dillwang/Advanced-CPU-Optimization/mips_cpu/mips_core/ooo/lsq.sv

/*
 * lsq.sv
 *
 * The load/store queue. It holds every memory instruction in program order from
 * dispatch until commit and owns the single D cache port.
 *
 * Ordering rules:
 *   - Stores never touch the cache speculatively. A store computes its address
 *     and data when it issues, sits in the queue, and is written to the cache
 *     only when the reorder buffer retires it. A squashed store therefore
 *     cannot have changed memory.
 *   - A load may issue ahead of an older store whose address is not known yet.
 *     That is a guess, and this module is where it is checked: when the store
 *     finally computes its address, any younger load that already read the same
 *     word is a memory order violation, and o_mv_valid asks the reorder buffer
 *     to squash it and everything after it. Loads the predictor has marked
 *     (mem_wait) are held by the issue queue instead, using
 *     o_oldest_unresolved, and cannot violate at all.
 *   - A load that matches an older store in the queue takes its value straight
 *     from the queue instead of the cache (store to load forwarding). The
 *     youngest matching older store wins.
 *
 * The D cache reads its SRAM using addr_next a cycle ahead of addr, so an
 * access is set up in the cycle the address is computed and presented in the
 * following one.
 *
 * The cache does not block on a miss, which means an access gets one of three
 * answers in the cycle it is presented rather than simply stalling:
 *
 *   dc_out.valid    it hit; the access is finished.
 *   dc_miss_pending it missed, and miss status holding register dc_mshr_id has
 *                   taken on the fill. The access leaves the port, its queue
 *                   entry is marked waiting, and the port is free immediately.
 *                   When dc_fill_valid announces that id, every entry waiting
 *                   on it is marked for replay and put back on the port, where
 *                   it hits.
 *   neither         the cache could not take it -- no free register, or the
 *                   line is still sitting in the writeback queue. The access
 *                   stays on the port and is presented again.
 *
 * Waiting is per queue entry rather than per port, so several loads can be
 * outstanding at once and their memory latencies overlap. Loads that hit keep
 * flowing past them.
 */
`include "mips_core.svh"

module lsq (
	input clk,    // Clock
	input rst_n,  // Synchronous reset active low

	// ---- dispatch ----
	input  uop_t disp_uop [FE_WIDTH],
	output lsq_idx_t disp_lsq_idx [FE_WIDTH],
	output logic [LSQ_IDX_W : 0] lsq_free,

	// ---- issue of a memory operation ----
	// The address comes from the ALU on the issuing port, the store data from
	// the second source operand.
	input  logic mem_issue,
	input  uop_t mem_uop,
	input  logic [`ADDR_WIDTH - 1 : 0] mem_addr,
	input  logic [`DATA_WIDTH - 1 : 0] mem_data,

	// ---- constraints published back to the issue queue ----
	output logic o_accept,
	output logic o_load_free,
	output logic o_has_unresolved,
	output rob_idx_t o_oldest_unresolved,
	input  rob_idx_t rob_head,

	// ---- memory order violation ----
	// A store has just found that this load read the word it is about to
	// write. Raised one cycle after the store computes its address, so that
	// the squash it causes does not feed back into the issue it came from.
	output logic o_mv_valid,
	output rob_idx_t o_mv_rob_idx,

	// ---- load writeback ----
	output logic ld_wb_valid,
	output rob_idx_t ld_wb_rob_idx,
	output preg_t ld_wb_pd,
	output logic ld_wb_writes,
	output logic [`DATA_WIDTH - 1 : 0] ld_wb_data,
	output logic [`ADDR_WIDTH - 1 : 0] ld_wb_addr,

	// ---- the committing store ----
	input  logic st_valid,
	input  logic [`ADDR_WIDTH - 1 : 0] st_addr,
	input  logic [`DATA_WIDTH - 1 : 0] st_data,
	output logic st_done,

	// ---- deallocation, driven by commit ----
	input  logic commit_en [FE_WIDTH],
	input  rob_idx_t commit_rob_idx [FE_WIDTH],
	input  logic commit_is_mem [FE_WIDTH],

	// ---- squash ----
	input  logic squash,
	input  rob_idx_t squash_head,
	input  logic [ROB_IDX_W : 0] squash_count,

	// ---- D cache ----
	d_cache_input_ifc.out dc_in,
	cache_output_ifc.in dc_out,
	// The access presented this cycle missed, and is covered by dc_mshr_id.
	input  logic dc_miss_pending,
	input  mshr_id_t dc_mshr_id,
	// That register's line has landed; anything waiting on it may be replayed.
	input  logic dc_fill_valid,
	input  mshr_id_t dc_fill_id
);

`ifdef SIMULATION
	import "DPI-C" function void stats_event (input string e);
`endif

	typedef struct packed {
		logic valid;
		logic is_store;
		rob_idx_t rob_idx;
		logic addr_valid;
		logic [`ADDR_WIDTH - 1 : 0] addr;
		logic [`DATA_WIDTH - 1 : 0] data;
		// A load that missed sits here, off the D cache port, until the fill it
		// is waiting on lands; it is then marked for replay and put back on.
		logic waiting;
		logic replay;
		mshr_id_t mshr_id;
		// Where a replayed load writes back. The issuing uop is long gone by
		// then, so the queue has to carry the destination itself.
		preg_t pd;
		logic writes;
		// For a load, the store it took its value from, if any. A store that
		// resolves late is only a violation for loads that did not already
		// forward from a store younger than it.
		logic fwd_valid;
		rob_idx_t fwd_src;
	} lsq_entry_t;

	lsq_entry_t e [LSQ_ENTRIES];
	lsq_idx_t lsq_head, lsq_tail;
	logic [LSQ_IDX_W : 0] lsq_count;

	// The access presented to the D cache this cycle. This is a one deep
	// pipeline register rather than a state machine: the cache addresses its
	// SRAM from addr_next and compares tags against addr, which are a cycle
	// apart, so an access can be set up in the same cycle that the previous one
	// completes. An idle-per-access state machine cannot do that and caps the
	// port at one access every two cycles, which on a load heavy program is the
	// binding limit long before the cache itself is.
	logic acc_valid;
	logic acc_is_store;
	logic [`ADDR_WIDTH - 1 : 0] acc_addr;
	logic [`DATA_WIDTH - 1 : 0] acc_data;	// store data
	rob_idx_t acc_rob;						// load identity
	preg_t acc_pd;
	logic acc_writes;
	logic acc_killed;
	lsq_idx_t acc_lsq;		// the entry to mark waiting if this access misses
	// Set for one cycle when a forwarded load will write back next cycle. The
	// access on the port is not presented to the cache that cycle, so it cannot
	// answer at the same time and contend for the single load writeback port.
	logic acc_hold;

	// The access to present next cycle, and whose address goes out on
	// addr_next now.
	logic nxt_valid;
	logic nxt_is_store;
	logic [`ADDR_WIDTH - 1 : 0] nxt_addr;
	logic [`DATA_WIDTH - 1 : 0] nxt_data;
	rob_idx_t nxt_rob;
	preg_t nxt_pd;
	logic nxt_writes;
	logic nxt_killed;
	lsq_idx_t nxt_lsq;
	logic nxt_hold;

	// A committing store that missed. It stays in the reorder buffer with
	// st_valid asserted, and is put back on the port when its fill lands.
	logic st_wait_valid;
	mshr_id_t st_wait_mshr;

	// ||||||||||||||||||||||||||||||||||||||||||||||||||||||||||||||||||||||||
	// |||| Disambiguation
	// ||||||||||||||||||||||||||||||||||||||||||||||||||||||||||||||||||||||||
	// The oldest store that has not yet produced an address. The issue queue
	// uses this to hold back any load younger than it.
	always_comb
	begin
		o_has_unresolved = 1'b0;
		o_oldest_unresolved = '0;
		for (int i = 0; i < LSQ_ENTRIES; i++)
		begin
			automatic logic [ROB_IDX_W : 0] a =
				{1'b0, rob_idx_t'(e[i].rob_idx - rob_head)};
			if (e[i].valid && e[i].is_store && !e[i].addr_valid)
			begin
				if (!o_has_unresolved
					|| (a < {1'b0, rob_idx_t'(o_oldest_unresolved - rob_head)}))
				begin
					o_has_unresolved = 1'b1;
					o_oldest_unresolved = e[i].rob_idx;
				end
			end
		end
	end

	// Store to load forwarding: the youngest store that is older than the
	// issuing load and hits the same word supplies the data.
	logic fwd_hit;
	logic [`DATA_WIDTH - 1 : 0] fwd_data;
	rob_idx_t fwd_src;
	logic [ROB_IDX_W : 0] issue_age;

	always_comb
	begin
		automatic logic [ROB_IDX_W : 0] best_age = '0;

		issue_age = {1'b0, rob_idx_t'(mem_uop.rob_idx - rob_head)};
		fwd_hit = 1'b0;
		fwd_data = '0;
		fwd_src = '0;

		for (int i = 0; i < LSQ_ENTRIES; i++)
		begin
			automatic logic [ROB_IDX_W : 0] a =
				{1'b0, rob_idx_t'(e[i].rob_idx - rob_head)};
			if (e[i].valid && e[i].is_store && e[i].addr_valid
				&& (a < issue_age) && (e[i].addr == mem_addr))
			begin
				// Keep the youngest match, which is the store that would have
				// been the last to write this word before the load runs.
				if (!fwd_hit || (a > best_age))
				begin
					fwd_hit = 1'b1;
					fwd_data = e[i].data;
					fwd_src = e[i].rob_idx;
					best_age = a;
				end
			end
		end
	end

	// ||||||||||||||||||||||||||||||||||||||||||||||||||||||||||||||||||||||||
	// |||| Memory order violation
	// ||||||||||||||||||||||||||||||||||||||||||||||||||||||||||||||||||||||||
	// A store computing its address late can find that a younger load has
	// already run and read the word it is about to write. That load took its
	// value from the cache, or forwarded from a store older than this one, and
	// is wrong -- as is everything that used it.
	//
	// This is the only cycle it can be discovered in. A load that has already
	// issued has already chosen where its data comes from, at issue, so the
	// check has to happen against every younger load that has an address.
	//
	// The oldest offender wins: squashing it takes the younger ones with it.
	logic mv_hit;
	rob_idx_t mv_rob;

	always_comb
	begin
		automatic logic [ROB_IDX_W : 0] best = '0;
		automatic logic [ROB_IDX_W : 0] s_age =
			{1'b0, rob_idx_t'(mem_uop.rob_idx - rob_head)};
		automatic logic st_issue = mem_issue && (mem_uop.mem_action == WRITE);

		mv_hit = 1'b0;
		mv_rob = '0;

		for (int i = 0; i < LSQ_ENTRIES; i++)
		begin
			automatic logic [ROB_IDX_W : 0] a =
				{1'b0, rob_idx_t'(e[i].rob_idx - rob_head)};
			// A load that forwarded from a store younger than this one already
			// holds the right value: this store is not the last write to that
			// word before it.
			automatic logic covered = e[i].fwd_valid
				&& ({1'b0, rob_idx_t'(e[i].fwd_src - rob_head)} > s_age);

			// MDP_STRESS drops the address test, so every store that resolves
			// behind an issued load reports a violation. Real programs almost
			// never alias here, which would leave the recovery path untested;
			// under stress it fires constantly and the golden traces still have
			// to match. Correctness only -- it is ruinously slow.
`ifdef MDP_STRESS
			if (st_issue && e[i].valid && !e[i].is_store && e[i].addr_valid
				&& (a > s_age))
`else
			if (st_issue && e[i].valid && !e[i].is_store && e[i].addr_valid
				&& (a > s_age) && (e[i].addr == mem_addr) && !covered)
`endif
			begin
				if (!mv_hit || (a < best))
				begin
					mv_hit = 1'b1;
					mv_rob = e[i].rob_idx;
					best = a;
				end
			end
		end
	end

	// Registered, and this is not optional: the squash it raises reaches the
	// issue queue, which is what produced the store issue that detected it.
	// Passing it out combinationally would close that loop. One cycle later
	// nothing has changed that matters -- the load cannot commit, because the
	// store that caught it is older and has not committed either.
	logic mv_pend_valid;
	rob_idx_t mv_pend_rob;
	logic mv_keep_pending;

	// If a second violation is found while one is still pending, the older of
	// the two is kept, because its squash covers the younger one anyway.
	assign mv_keep_pending = mv_pend_valid
		&& ({1'b0, rob_idx_t'(mv_rob - rob_head)}
			>= {1'b0, rob_idx_t'(mv_pend_rob - rob_head)});

	assign o_mv_valid = mv_pend_valid;
	assign o_mv_rob_idx = mv_pend_rob;

	// ||||||||||||||||||||||||||||||||||||||||||||||||||||||||||||||||||||||||
	// |||| D cache port
	// ||||||||||||||||||||||||||||||||||||||||||||||||||||||||||||||||||||||||
	// Priority on the port: an unfinished access keeps it, then a committing
	// store, then the oldest load whose fill has landed, then a newly issuing
	// load. Replays come before new loads so that a load which has already paid
	// for a miss cannot be starved by a stream of hits behind it.
	logic start_load;
	logic start_store;
	logic start_replay;
	logic store_slot;
	logic load_slot;
	logic acc_abandon;		// a squashed load, whose answer nobody wants
	logic acc_done;
	logic dc_present;		// the access is actually in front of the cache
	logic port_free;

	// The oldest entry whose fill has arrived.
	logic replay_found;
	lsq_idx_t replay_idx;

	always_comb
	begin
		automatic logic [ROB_IDX_W : 0] best = '0;

		replay_found = 1'b0;
		replay_idx = '0;
		for (int i = 0; i < LSQ_ENTRIES; i++)
		begin
			automatic logic [ROB_IDX_W : 0] a =
				{1'b0, rob_idx_t'(e[i].rob_idx - rob_head)};
			if (e[i].valid && e[i].replay)
			begin
				if (!replay_found || (a < best))
				begin
					replay_found = 1'b1;
					replay_idx = lsq_idx_t'(i);
					best = a;
				end
			end
		end
	end

	assign acc_abandon = acc_valid && !acc_is_store && acc_killed;
	assign dc_present = acc_valid && !acc_abandon && !acc_hold;
	// A hit and a miss both take the access off the port; only a refusal keeps
	// it. A miss is not a stall any more, so the port frees up in the cycle the
	// miss is taken and the very next access can go out behind it.
	assign acc_done = acc_valid && (acc_abandon
		|| (dc_present && (dc_out.valid || dc_miss_pending)));
	// The port can take a new access whenever it is empty or the access on it
	// finishes this cycle. That last case is what makes it a pipeline: the
	// finishing access is still being compared against addr while the next one
	// is already addressing the SRAM through addr_next.
	assign port_free = !acc_valid || acc_done;

	// A store that is already on the port, or that missed and is waiting for
	// its line, must not be launched a second time; st_valid stays asserted
	// until st_done answers it.
	assign store_slot = st_valid && !st_wait_valid
		&& !(acc_valid && acc_is_store);
	assign start_store = store_slot && port_free;
	assign start_replay = port_free && !start_store && replay_found;
	assign load_slot = port_free && !store_slot && !replay_found;
	assign start_load = mem_issue && (mem_uop.mem_action == READ) && !fwd_hit
		&& load_slot;

	// A forwarded load does not need the port at all, so a memory operation may
	// issue whenever the writeback port is not about to be contended. The one
	// cycle acc_hold takes the port out of the cache's view is also the one
	// cycle nothing new is allowed to issue, which bounds the hold to a cycle.
	assign o_accept = !acc_hold;
	// A load can only be set up when nothing else is claiming the port, since
	// the cache SRAM has to be addressed a cycle in advance. This must be the
	// exact predicate start_load uses, or a load the issue queue has already
	// dropped would never reach the port.
	assign o_load_free = load_slot;

	// A load that will be answered from the store queue next cycle. The cache
	// path has to stay quiet then, since they share one writeback port.
	logic fwd_next;
	assign fwd_next = mem_issue && (mem_uop.mem_action == READ) && fwd_hit;

	always_comb
	begin
		nxt_valid = 1'b0;
		nxt_is_store = 1'b0;
		nxt_addr = '0;
		nxt_data = '0;
		nxt_rob = '0;
		nxt_pd = '0;
		nxt_writes = 1'b0;
		nxt_killed = 1'b0;
		nxt_lsq = '0;

		if (acc_valid && !acc_done)
		begin
			// Refused, or held back for the writeback port: hold everything,
			// including addr_next, so the SRAM read is set up again.
			nxt_valid = 1'b1;
			nxt_is_store = acc_is_store;
			nxt_addr = acc_addr;
			nxt_data = acc_data;
			nxt_rob = acc_rob;
			nxt_pd = acc_pd;
			nxt_writes = acc_writes;
			nxt_lsq = acc_lsq;
			nxt_killed = acc_killed
				|| (squash && !acc_is_store
					&& ({1'b0, rob_idx_t'(acc_rob - squash_head)} >= squash_count));
		end
		else if (start_store)
		begin
			nxt_valid = 1'b1;
			nxt_is_store = 1'b1;
			nxt_addr = st_addr;
			nxt_data = st_data;
		end
		else if (start_replay)
		begin
			nxt_valid = 1'b1;
			nxt_addr = e[replay_idx].addr;
			nxt_rob = e[replay_idx].rob_idx;
			nxt_pd = e[replay_idx].pd;
			nxt_writes = e[replay_idx].writes;
			nxt_lsq = replay_idx;
			nxt_killed = squash
				&& ({1'b0, rob_idx_t'(e[replay_idx].rob_idx - squash_head)}
					>= squash_count);
		end
		else if (start_load)
		begin
			nxt_valid = 1'b1;
			nxt_addr = mem_addr;
			nxt_rob = mem_uop.rob_idx;
			nxt_pd = mem_uop.pd;
			nxt_writes = mem_uop.uses_rw;
			nxt_lsq = mem_uop.lsq_idx;
		end

		nxt_hold = nxt_valid && !nxt_is_store && fwd_next;
	end

	always_comb
	begin
		dc_in.valid = dc_present;
		dc_in.mem_action = acc_is_store ? WRITE : READ;
		dc_in.addr = acc_addr;
		dc_in.data = acc_data;
		// The address the cache should read its SRAM at for next cycle. When
		// nothing follows, leave the current address there rather than zero, so
		// a stalled access keeps its own row selected.
		dc_in.addr_next = nxt_valid ? nxt_addr : acc_addr;
	end

	assign st_done = acc_valid && acc_is_store && dc_present && dc_out.valid;

	// The register the cache names may be retiring on this very cycle, in which
	// case its fill announcement has already gone past and waiting on it would
	// never end. Go straight to replay instead.
	logic fill_now;
	assign fill_now = dc_fill_valid && (dc_fill_id == dc_mshr_id);

	// ||||||||||||||||||||||||||||||||||||||||||||||||||||||||||||||||||||||||
	// |||| Load writeback
	// ||||||||||||||||||||||||||||||||||||||||||||||||||||||||||||||||||||||||
	// A forwarded load is answered the cycle after it issues; a load that went
	// to the cache is answered when the cache returns.
	logic fwd_pending;
	rob_idx_t fwd_rob;
	preg_t fwd_pd;
	logic fwd_writes;
	logic [`DATA_WIDTH - 1 : 0] fwd_val;
	logic [`ADDR_WIDTH - 1 : 0] fwd_addr;

	// A squash landing on the same cycle as a completion cancels that
	// completion only when the load is genuinely on the wrong path. Cancelling
	// unconditionally would drop the result of a load that survived, and its
	// reorder buffer entry would then never complete.
	logic fwd_squashed, ld_squashed;
	assign fwd_squashed = squash
		&& ({1'b0, rob_idx_t'(fwd_rob - squash_head)} >= squash_count);
	assign ld_squashed = squash
		&& ({1'b0, rob_idx_t'(acc_rob - squash_head)} >= squash_count);

	always_comb
	begin
		if (fwd_pending)
		begin
			ld_wb_valid = ~fwd_squashed;
			ld_wb_rob_idx = fwd_rob;
			ld_wb_pd = fwd_pd;
			ld_wb_writes = fwd_writes;
			ld_wb_data = fwd_val;
			ld_wb_addr = fwd_addr;
		end
		else
		begin
			ld_wb_valid = acc_valid && !acc_is_store && dc_present
				&& dc_out.valid && !acc_killed && !ld_squashed;
			ld_wb_rob_idx = acc_rob;
			ld_wb_pd = acc_pd;
			ld_wb_writes = acc_writes;
			ld_wb_data = dc_out.data;
			ld_wb_addr = acc_addr;
		end
	end

	// ||||||||||||||||||||||||||||||||||||||||||||||||||||||||||||||||||||||||
	// |||| Allocation
	// ||||||||||||||||||||||||||||||||||||||||||||||||||||||||||||||||||||||||
	logic [LSQ_IDX_W : 0] alloc_n;

	always_comb
	begin
		alloc_n = '0;
		for (int k = 0; k < FE_WIDTH; k++)
		begin
			disp_lsq_idx[k] = lsq_idx_t'(lsq_tail + alloc_n[LSQ_IDX_W - 1 : 0]);
			if (disp_uop[k].valid && disp_uop[k].is_mem)
				alloc_n = alloc_n + 1'b1;
		end
		lsq_free = (LSQ_ENTRIES - 1) - lsq_count;
	end

	// ||||||||||||||||||||||||||||||||||||||||||||||||||||||||||||||||||||||||
	// |||| State update
	// ||||||||||||||||||||||||||||||||||||||||||||||||||||||||||||||||||||||||
	logic [LSQ_IDX_W : 0] dealloc_n;
	logic [LSQ_IDX_W : 0] survivors;

	always_ff @(posedge clk)
	begin
		if (~rst_n)
		begin
			for (int i = 0; i < LSQ_ENTRIES; i++)
			begin
				e[i].valid <= 1'b0;
				e[i].addr_valid <= 1'b0;
				e[i].waiting <= 1'b0;
				e[i].replay <= 1'b0;
			end
			lsq_head <= '0;
			lsq_tail <= '0;
			lsq_count <= '0;
			acc_valid <= 1'b0;
			acc_is_store <= 1'b0;
			acc_killed <= 1'b0;
			acc_hold <= 1'b0;
			st_wait_valid <= 1'b0;
			fwd_pending <= 1'b0;
			mv_pend_valid <= 1'b0;
		end
		else
		begin
			// The D cache port, advanced by one access.
			acc_valid <= nxt_valid;
			acc_is_store <= nxt_is_store;
			acc_addr <= nxt_addr;
			acc_data <= nxt_data;
			acc_rob <= nxt_rob;
			acc_pd <= nxt_pd;
			acc_writes <= nxt_writes;
			acc_killed <= nxt_killed;
			acc_lsq <= nxt_lsq;
			acc_hold <= nxt_hold;
			// Driven from exactly one place, so that the squash handling below
			// cannot silently override a forward being set this cycle.
			fwd_pending <= mem_issue && (mem_uop.mem_action == READ) && fwd_hit;

			// ---- issue: record the address, and the data for a store ----
			if (mem_issue)
			begin
				e[mem_uop.lsq_idx].addr <= mem_addr;
				e[mem_uop.lsq_idx].addr_valid <= 1'b1;
				if (mem_uop.mem_action == WRITE)
					e[mem_uop.lsq_idx].data <= mem_data;
				else
				begin
					// Kept so a replay after a miss can write back without the
					// uop, which is retired from the issue queue by then.
					e[mem_uop.lsq_idx].pd <= mem_uop.pd;
					e[mem_uop.lsq_idx].writes <= mem_uop.uses_rw;
					// And which store it took its value from, so a store that
					// resolves later can tell whether it was overtaken.
					e[mem_uop.lsq_idx].fwd_valid <= fwd_hit;
					e[mem_uop.lsq_idx].fwd_src <= fwd_src;
				`ifdef SIMULATION
					if (o_has_unresolved
						&& (issue_age > {1'b0,
							rob_idx_t'(o_oldest_unresolved - rob_head)}))
						stats_event("memdep_speculated");
				`endif
				end

				// A load that misses the forwarding path is picked up by the
				// port logic above, which owns acc_* outright so that a squash
				// arriving on the same edge cannot race it.
				if ((mem_uop.mem_action == READ) && fwd_hit)
				begin
					fwd_rob <= mem_uop.rob_idx;
					fwd_pd <= mem_uop.pd;
					fwd_writes <= mem_uop.uses_rw;
					fwd_val <= fwd_data;
					fwd_addr <= mem_addr;
				`ifdef SIMULATION
					stats_event("store_forward");
				`endif
				end
			end

			// ---- memory order violation, held for one cycle ----
			if (mv_hit && !mv_keep_pending)
			begin
				mv_pend_valid <= 1'b1;
				mv_pend_rob <= mv_rob;
			end
			else
				mv_pend_valid <= 1'b0;

			// ---- a fill lands: everything behind it may be replayed ----
			if (dc_fill_valid)
			begin
				for (int i = 0; i < LSQ_ENTRIES; i++)
				begin
					if (e[i].valid && e[i].waiting && (e[i].mshr_id == dc_fill_id))
					begin
						e[i].waiting <= 1'b0;
						e[i].replay <= 1'b1;
					end
				end

				if (st_wait_valid && (dc_fill_id == st_wait_mshr))
					st_wait_valid <= 1'b0;
			end

			// ---- a replay claims the port ----
			if (start_replay)
				e[replay_idx].replay <= 1'b0;

			// ---- the access on the port missed ----
			// It leaves the port either way; a load parks in its queue entry
			// and a committing store parks in st_wait, and both come back when
			// the fill is announced.
			if (dc_present && dc_miss_pending)
			begin
				if (acc_is_store)
				begin
					st_wait_valid <= !fill_now;
					st_wait_mshr <= dc_mshr_id;
				end
				else
				begin
					e[acc_lsq].waiting <= !fill_now;
					e[acc_lsq].replay <= fill_now;
					e[acc_lsq].mshr_id <= dc_mshr_id;
				end
			`ifdef SIMULATION
				stats_event("lsq_miss_park");
			`endif
			end

			// ---- allocation ----
			for (int k = 0; k < FE_WIDTH; k++)
			begin
				if (disp_uop[k].valid && disp_uop[k].is_mem)
				begin
					e[disp_lsq_idx[k]].valid <= 1'b1;
					e[disp_lsq_idx[k]].is_store <= (disp_uop[k].mem_action == WRITE);
					e[disp_lsq_idx[k]].rob_idx <= disp_uop[k].rob_idx;
					e[disp_lsq_idx[k]].addr_valid <= 1'b0;
					e[disp_lsq_idx[k]].waiting <= 1'b0;
					e[disp_lsq_idx[k]].replay <= 1'b0;
				end
			end

			// ---- deallocation on commit ----
			dealloc_n = '0;
			for (int k = 0; k < FE_WIDTH; k++)
			begin
				if (commit_en[k] && commit_is_mem[k])
				begin
					e[lsq_idx_t'(lsq_head + dealloc_n[LSQ_IDX_W - 1 : 0])].valid <= 1'b0;
					e[lsq_idx_t'(lsq_head + dealloc_n[LSQ_IDX_W - 1 : 0])].addr_valid <= 1'b0;
					e[lsq_idx_t'(lsq_head + dealloc_n[LSQ_IDX_W - 1 : 0])].waiting <= 1'b0;
					e[lsq_idx_t'(lsq_head + dealloc_n[LSQ_IDX_W - 1 : 0])].replay <= 1'b0;
					dealloc_n = dealloc_n + 1'b1;
				end
			end

			lsq_head <= lsq_idx_t'(lsq_head + dealloc_n[LSQ_IDX_W - 1 : 0]);
			lsq_tail <= lsq_idx_t'(lsq_tail + alloc_n[LSQ_IDX_W - 1 : 0]);
			lsq_count <= lsq_count - dealloc_n + alloc_n;

			// ---- squash ----
			if (squash)
			begin
				survivors = '0;
				for (int i = 0; i < LSQ_ENTRIES; i++)
				begin
					if (e[i].valid)
					begin
						if ({1'b0, rob_idx_t'(e[i].rob_idx - squash_head)} >= squash_count)
						begin
							e[i].valid <= 1'b0;
							e[i].addr_valid <= 1'b0;
							// A wrong path load waiting on a fill simply stops
							// waiting. The fill still lands in the cache.
							e[i].waiting <= 1'b0;
							e[i].replay <= 1'b0;
						end
						else
							survivors = survivors + 1'b1;
					end
				end

				// A load already talking to the cache may now be wrong path.
				// That is handled where acc_* is computed, which carries the
				// kill into nxt_killed rather than writing acc_killed from two
				// places on the same edge.

				lsq_count <= survivors - dealloc_n;
				lsq_tail <= lsq_idx_t'(lsq_head + dealloc_n[LSQ_IDX_W - 1 : 0]
					+ (survivors[LSQ_IDX_W - 1 : 0] - dealloc_n[LSQ_IDX_W - 1 : 0]));
			end
		end
	end

`ifdef SIMULATION
	// Cycles with at least one load parked on a fill. Compare against the
	// cycle count to see how much of the run is covered by an outstanding miss,
	// and against Dmiss_inflight to see how much of that overlaps.
	always_ff @(posedge clk)
	begin
		if (rst_n)
		begin
			for (int i = 0; i < LSQ_ENTRIES; i++)
			begin
				if (e[i].valid && e[i].waiting)
				begin
					stats_event("lsq_wait_cycle");
					break;
				end
			end
		end
	end
`endif

endmodule
