dillwang/Advanced-CPU-Optimization/mips_cpu/mips_core/alu.sv

/*
 * alu.sv
 * Author: Pravin P. Prabhu & Zinsser Zhang
 * Last Revision: 04/08/2018
 *
 * Defines the input and output interface of arithmetic logic unit in execution
 * stage. Implement the alu which can do arithmetic calculations and branch
 * resolution.
 *
 * It is also reponsible for reporting customized MTC0 instructions
 * to pass_done interface. See wiki page "Pass Done Interface" for details.
 */
`include "mips_core.svh"

interface alu_input_ifc ();
	logic valid;
	mips_core_pkg::AluCtl alu_ctl;
	logic signed [`DATA_WIDTH - 1 : 0] op1;
	logic signed [`DATA_WIDTH - 1 : 0] op2;

	modport in  (input valid, alu_ctl, op1, op2);
	modport out (output valid, alu_ctl, op1, op2);
endinterface

interface alu_output_ifc ();
	logic valid;
	logic [`DATA_WIDTH - 1 : 0] result;
	mips_core_pkg::BranchOutcome branch_outcome;

	modport in  (input valid, result, branch_outcome);
	modport out (output valid, result, branch_outcome);
endinterface

module alu (
	alu_input_ifc.in in,
	alu_output_ifc.out out,
	output logic done
);

	always_comb
	begin
		out.valid = 1'b0;
		out.result = '0;
		out.branch_outcome = NOT_TAKEN;
		done = 1'b0;

		if (in.valid)
		begin
			out.valid = 1'b1;

			case (in.alu_ctl)
				ALUCTL_NOP:  out.result = '0;
				ALUCTL_ADD:  out.result = in.op1 + in.op2;
				ALUCTL_ADDU: out.result = in.op1 + in.op2;
				ALUCTL_SUB:  out.result = in.op1 - in.op2;
				ALUCTL_SUBU: out.result = in.op1 - in.op2;
				ALUCTL_AND:  out.result = in.op1 & in.op2;
				ALUCTL_OR:   out.result = in.op1 | in.op2;
				ALUCTL_XOR:  out.result = in.op1 ^ in.op2;
				ALUCTL_SLT:  out.result = in.op1 < in.op2;
				ALUCTL_SLTU: out.result = unsigned'(in.op1) < unsigned'(in.op2);
				ALUCTL_SLL:  out.result = in.op1 << unsigned'(in.op2);
				ALUCTL_SRL:  out.result = in.op1 >> unsigned'(in.op2);
				ALUCTL_SRA:  out.result = in.op1 >>> unsigned'(in.op2);
				ALUCTL_SLLV: out.result = in.op2 << in.op1[4:0];
				ALUCTL_SRLV: out.result = in.op2 >> in.op1[4:0];
				ALUCTL_SRAV: out.result = in.op2 >>> in.op1[4:0];
				ALUCTL_NOR:  out.result = ~(in.op1 | in.op2);

				// MTC0 -- redefined for our purposes. The test number is
				// passed through as the result so that commit, which is the
				// only place that knows an instruction is on the correct
				// path, can report it. Reporting from here would print tests
				// that the machine later squashes.
				ALUCTL_MTC0_PASS: out.result = in.op2;
				ALUCTL_MTC0_FAIL: out.result = in.op2;
				ALUCTL_MTC0_DONE: out.result = in.op2;

				ALUCTL_BA:   out.branch_outcome = TAKEN;
				ALUCTL_BEQ:  out.branch_outcome = in.op1 == in.op2     ? TAKEN : NOT_TAKEN;
				ALUCTL_BNE:  out.branch_outcome = in.op1 != in.op2     ? TAKEN : NOT_TAKEN;
				ALUCTL_BLEZ: out.branch_outcome = in.op1 <= signed'(0) ? TAKEN : NOT_TAKEN;
				ALUCTL_BGTZ: out.branch_outcome = in.op1 > signed'(0)  ? TAKEN : NOT_TAKEN;
				ALUCTL_BGEZ: out.branch_outcome = in.op1 >= signed'(0) ? TAKEN : NOT_TAKEN;
				ALUCTL_BLTZ: out.branch_outcome = in.op1 < signed'(0)  ? TAKEN : NOT_TAKEN;

				default:
				begin
				`ifdef SIMULATION
					$display("%m (%t) Illegal ALUCTL code %b", $time, in.alu_ctl);
				`endif
				end
			endcase
		end
	end
endmodule
