dillwang/Advanced-CPU-Optimization/(commit log)

2025-01-15 Added the 5 stage baseline cpu design in the directory.
    Added the 5 stage baseline cpu design in the directory. This includes the baseline sv files, architecture designs, memory component, a hexcode generator, etc.
2025-01-15 Project 0 mods
    Added code to count and display D and I cache hits and misses
    changed set associativity to 4 from 2
    Replaced tabs with spaces
    [branch_controller.sv, d_cache.sv, i_cache.sv]
2025-01-27 Start of perceptron development
    Beginning work on developing the perceptron. Made files for the calculator, trainer, weight table, and weight updater, and the top level, though these are incomplete.
    Format fix for hazard controller file
    [branch_predictorTL.sv, hazard_controller.sv, perceptron_calc.sv, perceptron_trainer.sv, weight_table.sv]
2025-01-28 small fix to branch controller + misc
    [branch_controller.sv, branch_predictorTL.sv, perceptron_calc.sv, weight_table.sv]
2025-01-28 Fixing the perceptron files
    cleaner, better
    [ghr.sv, perceptron_calc.sv, perceptron_trainer.sv, weight_table.sv]
2025-01-30 Large corrections and overhauls of perceptron code
    Will need to look this over to make sure the logic checks out and everything is connected
    [branch_predictorTL.sv, ghr.sv, perceptron_calc.sv, perceptron_trainer.sv, weight_table.sv]
2025-01-30 Fixed issues with synthesization
    put stats_events in ifdef block
    [d_cache.sv, i_cache.sv]
2025-01-30 Parameter doesn't change associativity
    LRU is hardcoded for 2 way, so it will need more changes
    [d_cache.sv]
2025-01-30 fixed parameters to be based off toplevel
    TODO: wire up like in branchcontroller.sv
    [branch_predictorTL.sv, ghr.sv, perceptron_calc.sv, perceptron_trainer.sv, weight_table.sv]
2025-01-31 Fixed some bugs for i-cache
    [i_cache.sv]
2025-02-03 Some bug/logic fixes of perceptron
    Problem might exist with foreach but online stuff seems to say it works
    [perceptron_predictor.sv]
2025-03-01 Changes to register renaming and instruction queue
    Added logic for adding and removing instructions from instruction queue
    Made the number of regs in reg_file match physical register number
    Fixed some register renaming logic
    Began creation of register renaming ifc
    TODO:
    1. figure out which signals and how to passthrough from decode to reg read stage
    2. handle stalls
    3. create ifc
    4. handle inputs and outputs of each pipeline register
    5. connect stages to HC, glue circuit, etc
    6. WB and commit logic
    [InstrQueue.sv, mips_core_interfaces.sv, reg_file.sv]
2025-03-11 some new logic stuff for IQ and RR
    current things I need to add for RR and OoO(list just in case):
    Pipeline registers
    Stall logic (still unsure how exactly I want to implement this)
    figure out if im using the decode.valid thing correctly(i havent figured out exactly what its doing tbh)
    determine how to know when to send the next instr(stall makes write 0 and freezes?)
    connections(these should be simple ifc stuff)
    [InstrQueue.sv]
2025-03-11 implemented some new things
    decode + rr to scheduling stage register: need to double check *all* connections
    register renaming: I need to make the busy bit table asynchronous + add writeback and stuff
2025-03-16 Cleaned up some code, added references for future additions
    Cleaned up messy code and comments, added alu info reference for IQ and passthrough,
    Added todos to keep track of what needs to be done
    TODO: refactor into legible sections for each functional part of the code
2025-03-19 updates to files for reg renaming without OoO
    changed reg file to work with reg renaming directly,
    register to ex now includes reg ren ifc but still needs to correct connections(!)
    glue circuit for decode updated to use reg renaming
    reg renaming has more logic now, need to figure out logic for writeback and recovery, then it's done(plus bugfixes)
    [glue_circuits.sv, pipeline_registers.sv, reg_file.sv]
2025-03-20 No more out of order
    lots of fixes and adjustments to register renaming, registers, forwarding unit, glue circuits for specifically register renaming without out of order
    [forward_unit.sv, glue_circuits.sv, hazard_controller.sv, pipeline_registers.sv]
2025-03-20 Updates and logic corrections
    Check forwarding unit: addr or phys?
    check if writeback works
    need to do commit logic
    busy bit table should now be asyncronous
    [forward_unit.sv, reg_file.sv]
2025-03-20 too many fixes
    all nighter
    [forward_unit.sv, glue_circuits.sv, hazard_controller.sv, mips_core.sv, mips_core_pkg.sv, reg_file.sv]
2025-03-20 small reg file syntax fixes
    [reg_file.sv]
2025-03-23 fixed logic error to properly use past prediction
    [perceptron_predictor.sv]
2026-08-25 Replace in-order pipeline with a 2-wide superscalar out-of-order core
    Rebuilds the back end as an out-of-order machine and fixes the three
    optimizations the README claimed but that were not working.
    New RTL under mips_core/ooo/:
    frontend fetch, fetch buffer, decode, predict, delay-slot redirects
    rename_rob register map, free list, busy table, ROB, commit, recovery
    issue_queue instruction window, CAM-free wakeup, oldest-first select
    lsq disambiguation, store-to-load forwarding, D-cache port
    prf unified physical register file
    ooo_backend back-end glue and execution units
    Notable design points:
    - Wakeup needs no CAM. The PRF is written at the end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
    [InstrQueue.sv, alu.sv, d_cache.sv, forward_unit.sv, frontend.sv, glue_circuits.sv, hazard_controller.sv, i_cache.sv]
2026-08-25 4-way D-cache with true LRU, a stride prefetcher, and a deterministic halt
    Cache:
    - associativity 2 -> 4, which also takes capacity to 16 KB at the same
    index width
    - replacement rewritten to match. The single lru_rp bit per set is exact
    LRU for two ways and meaningless for four; it is now a per-set recency
    permutation with invalid ways preferred as victims
    - hit detection and victim selection generalised over ASSOCIATIVITY
    Prefetcher:
    - stride detected on the miss stream rather than per load PC, so it needs
    no PC plumbed into the cache and still tracks an array walk; falls back
    to next line when no stride is confirmed
    - fills through the cache's own refill pat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
    [d_cache.sv, lsq.sv, mips_core.sv, ooo_backend.sv, rename_rob.sv]
2026-08-25 Predict in fetch with a BTB, and pipeline the D-cache port
    Two changes, both aimed at the front end diagnosis recorded in the previous
    commit: coin was spending 21% of its cycles with an empty fetch buffer at a
    0.009% instruction cache miss rate, one starved cycle per conditional branch.
    A branch target buffer moves prediction from decode into fetch. It is probed
    with the address being fetched in parallel with the instruction cache, so the
    next fetch address is already the target and nothing on the wrong path is ever
    fetched. Decode still checks the result by comparing where fetch went against
    where it should have gone, and fills the table when they differ; a static branch
    therefore misses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
    [btb.sv, d_cache.sv, frontend.sv, lsq.sv, mips_core_pkg.sv, rename_rob.sv]
2026-08-25 Instrument window readiness and D-cache miss predictability
    Simulation-only counters, added so that "would a wider machine help" and "would
    a better prefetcher help" are measurements rather than opinions.
    issue_queue counts how many entries are ready each cycle, independent of how
    many the two issue ports can take, plus how many of those are memory operations
    competing for the single cache port. d_cache counts true miss events alongside
    the existing miss-cycle counter, and how often a miss sits at the same delta
    from the previous one.
    What they say:
    ready >= 3 coin 12.9% esift2 23.4% nqueens 46.7%
    ready >= 4 coin 5.7% esift2 9 cycles in 4.8 M nqueens 24.8%
    >=2 mem rea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
    [d_cache.sv, issue_queue.sv]
2026-08-25 Make the D-cache non-blocking with miss status holding registers
    A miss no longer takes the cache into a refill state machine. Each of four
    registers records one line fill in flight -- its tag, index and target way --
    and a miss allocates one and answers "pending" instead of stalling, so the next
    cycle the cache can serve a hit or take another miss. Reads on one AXI id come
    back in order, so the registers are a FIFO and returning data always belongs to
    the head; no reply matching is needed.
    The wait list lives in the load/store queue rather than the cache. An access
    gets one of three answers: it hit, it is covered by register N, or it was
    refused and must be presented again. A load told to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
    [d_cache.sv, lsq.sv, mips_core.sv, ooo_backend.sv]
2026-08-25 Measure what is actually left: memory dependence, not fetch width
    Adds two counters to the issue queue. memdep_held counts cycles where a load
    has both operands and is held back only because an older store has not computed
    its address yet; memdep_held_idle counts the subset where nothing else is ready
    to issue either, so that load is the whole cost.
    The second number is the useful one and it is very uneven:
    quickSort 854,588 18.9% of the run
    coin 0
    nqueens 0
    esift2 3
    On coin and nqueens a held load never costs a cycle, because something else is
    always ready to take the slot. On quickSort there is nothing else, and it is the
    largest single measured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
    [issue_queue.sv]
2026-08-25 Let loads speculate past unresolved stores
    A load used to wait until every older store had computed its address. That
    makes disambiguation exact and replay unnecessary, and on quickSort it is also
    854,588 cycles -- 18.9% of the run -- with nothing at all ready to issue and a
    load sitting there holding both its operands.
    Loads now issue past unresolved stores, and the store checks the guess when it
    resolves: the load/store queue scans for younger loads that already have an
    address and hit the same word, and the oldest offender is squashed along with
    everything after it. A load that forwarded from a store younger than the one
    resolving is not a violation, so each load records which store it f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
    [issue_queue.sv, lsq.sv, mips_core_pkg.sv, ooo_backend.sv, rename_rob.sv]
2026-08-25 Double the physical register file: it was bounding the window, not the ROB
    Widening the window was on the dead-end list at 1.02x. That measurement was
    taken with a blocking D-cache, where D-cache miss cycles came out identical to
    within one cycle whatever the window size, so it could not have shown anything.
    Redoing it now that misses overlap -- and attributing every dispatch stall to
    the resource that ran out, rather than scaling everything and hoping:
    quickSort 1,251,515 stalls 100% free list
    coin 2,105,508 stalls 99.98% load/store queue
    esift2 93,576 stalls 100% load/store queue
    nqueens 10,713 stalls 84% load/store queue, 17% free list
    The reor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
    [mips_core_pkg.sv, rename_rob.sv]
2026-08-25 Size the window from the stall counters: ROB 128, LSQ 32
    Follows the free-list fix. With PHYS_REGS at 128 the reorder buffer became
    100% of quickSort's dispatch stalls, and raising it turns out to need four
    lines and no RTL change at all -- contrary to the note in this repo's history.
    The five BLKLOOPINIT errors at ROB_ENTRIES = 128 are all one construct: a
    non-blocking assignment to an element of an unpacked array inside a for loop,
    in the reset and squash walks over `rob` and `rmt`. Verilator accepts that only
    when it can fully unroll the loop and its default unroll budget is 64, which is
    exactly why the design elaborates at 64 entries and fails at 128.
    --unroll-count 512 --unroll-stmts 1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
    [mips_core_pkg.sv]
2026-08-25 Split the cycles that issue nothing, and correct the fetch-width claim
    Adds counters that attribute every cycle issuing no instruction to one of
    three exclusive causes -- window empty, window holds work but nothing has its
    operands, or something is ready and could not start -- plus window occupancy
    buckets and a count of how many uops the front end actually offers rename.
    The result overturns what this README said about fetch width.
    benchmark issues nothing empty none ready blocked >=16 when stuck
    coin 22.9% 0.9% 20.6% 1.4% 0%
    quickSort 18.1% 6.9% 10.6% 0.6% 69%
    esift2 8.3% 2.6%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
    [issue_queue.sv, rename_rob.sv]
2026-08-25 Fetch wider than decode: FETCH_WIDTH 4, FE_WIDTH 2
    The front end was offering rename a single instruction on half of coin's
    cycles while fetch_starved sat at 0.6%, because two things each cost a
    half-width fetch and neither empties the buffer. Counting the short fetches
    directly:
    the pair straddles the end of a 4-word cache line 5,859,615 45.0%
    the delay slot of a taken branch fell outside it 7,008,269 53.8%
    no room in the fetch buffer 149,545 1.1%
    7,008,269 against 7,181,543 conditional branches is 0.98 per branch: every
    taken branch cost a half-width cycle, because MIPS runs the delay slot and it
    was not in the pair.
    Note this is NOT the group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
    [btb.sv, frontend.sv, i_cache.sv, mips_core.sv, mips_core_interfaces.sv, mips_core_pkg.sv, stream_buffer.sv]
2026-08-25 Go three wide: FE_WIDTH 3, ISSUE_WIDTH 3
    Widening had been rejected twice, both times because three or more
    instructions were ready on only 8.8% of coin's cycles and 23.4% of esift2's.
    That was true and it stopped being true when fetch stopped starving the window:
    coin's ready>=3 went 20.9% -> 38.4% after the previous commit, and iq_blocked
    (ready but could not start) tripled to 4.5%.
    Both widths are single parameters -- ALUs, register file ports and writeback
    ports are generate loops over ISSUE_WIDTH; decode, rename, dispatch and commit
    are loops over FE_WIDTH -- so they were measured separately, which mattered:
    benchmark 2-wide ISSUE_WIDTH 3 + FE_WIDTH 3
    nqueens 75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
    [frontend.sv, mips_core_pkg.sv, ooo_backend.sv, rename_rob.sv]
2026-08-25 End the decode group at a branch only when it needs a redirect
    The group used to end at every control instruction so that decode raises at
    most one redirect per cycle. That was free at two wide -- a branch in the first
    slot still took its delay slot with it -- and costs a slot per branch at three,
    where coin accepted one instruction of three on 32.3% of its cycles.
    The guard is for a case that barely happens: coin takes two decode redirects in
    35.8M instructions, because the target buffer predicts nearly everything
    correctly. The group now ends at a branch only when want_redirect is actually
    set. A branch whose delay slot is not yet fetched still ends the group and
    defers through set_pend e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
    [frontend.sv]
2026-08-25 Eight-word instruction cache lines, FETCH_WIDTH 8
    The short-fetch mechanism that survived widening fetch from two to four is a
    branch landing in the last pushed slot, which forces its delay slot into a
    fetch cycle of its own -- still about one per taken branch. At a four-word
    group that is one branch in four; at eight it is one in eight. So the
    instruction cache is regeometried to eight-word lines at the same 8 KB
    (2 ways x 128 sets x 8 words, INDEX_WIDTH 7, BLOCK_OFFSET_WIDTH 3), the stream
    buffer follows it, and FETCH_WIDTH goes to 8 with a 32-entry fetch buffer.
    The frontend's fetch counters were pinned to three bits; they are now
    FCNT_W = $clog2(FETCH_WIDTH) + 1 so they scale with the w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
    [frontend.sv, i_cache.sv, mips_core_pkg.sv, stream_buffer.sv]
2026-08-26 Recover branch history from a sequence number, and add two predictors
    The branch history was previously copied into every reorder buffer entry, a
    BP_HISTORY-bit field per entry, so that a squash could restore it. That is not
    how the history is repaired in practice and it does not scale: at 128 entries
    and a 30-bit history it is 3,840 bits of shadow state whose only job is to be
    shifted back.
    Replaced with a sequence number. The predictor keeps one long shift register of
    BP_HISTORY + BP_ROLL bits and stamps each prediction with an 8-bit sequence
    number; recovery to sequence s is then a right shift by (now - s), because a
    direction history is a pure shift and the bits that were shifted in are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
    [frontend.sv, mips_core.sv, mips_core_pkg.sv, ooo_backend.sv, rename_rob.sv, tage_m1.sv, tage_predictor.sv, tournament_predictor.sv]
2026-08-26 Add the SC of TAGE-SC-L to the M1 shaped predictor
    Instrumenting where the mispredictions actually come from settles which
    component to build next. On nqueens, 36,535 of 38,733 misses are a tagged entry
    matching and giving the wrong answer; only 2,198 are branches with no tagged
    entry at all. More tables or more history do nothing about the first number,
    because the entry is there and it is wrong.
    So this adds the statistical corrector rather than more TAGE. Many weakly
    correlated signed counters are summed, perceptron style, and the sign of the
    sum overrides the tagged prediction when its magnitude clears an adaptive
    threshold. Three families: bias tables indexed by pc, by pc with the TAGE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
    [mips_core.sv, mips_core_pkg.sv, statistical_corrector.sv, tage_m1.sv]
2026-08-26 Go four wide, and make the data side actually prefetch
    Four changes, in the order the counters asked for them. Three of the four
    reverse a verdict this repository had already recorded as measured, and every
    one of those had been measured on a materially different machine.
    FOUR WIDE. The note said 4-wide was not worth building because three or more
    instructions were ready on 8.8% of coin's cycles. That was a 64-entry reorder
    buffer behind a 2-wide front end. At ROB 128 with a 3-wide front end the same
    counter reads 68% on esift2, which was issuing its full width two cycles in
    three. FE_WIDTH and ISSUE_WIDTH were already fully parameterised, so this is
    two parameters and three counters:
    co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
    [d_cache.sv, d_prefetcher.sv, mips_core.sv, mips_core_pkg.sv, ooo_backend.sv, rename_rob.sv]
2026-08-26 Make the architecture section describe the machine that exists
    The diagram and the code table had been left behind by two widenings and four
    new modules: 2 ALUs where there are 4, a 64-entry reorder buffer where there
    are 128, commit 2 wide where it is 4, and no mention of the predictor actually
    wired in.
    - Diagram and the Out of Order Execution bullets carry the current sizes, with
    the original ones kept as the note they always were: the mechanisms that
    section describes are unchanged, only every number moved.
    - Added a sizing table covering both widths, the whole window, both caches,
    the predictor and both prefetchers, so the current configuration is readable
    in one place instead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
2026-08-26 Describe the predictor that is actually in the machine
    The Branch Prediction section opened on the tournament predictor, which is no
    longer wired in, and reached the one that is only through a pointer to a
    results section three quarters of the way down the file.
    It now leads with the M1-shaped TAGE and says what makes it not textbook TAGE:
    path history rather than direction history, two registers folded from targets
    and from branch addresses, six four-way tables on the paper's history lengths,
    and the recovery consequence that follows from it -- a direction history is a
    pure shift so undoing k branches is a right shift, but (PHR << 1) ^ A is not
    invertible without A, which is the whole reas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
2026-08-26 Take the core to GDS with LibreLane on nanoHUB
    An asic/ directory that drives this core through synthesis, floorplan,
    placement, CTS, routing and signoff, and one script that runs all of it.
    LibreLane rather than OpenLane. nanoHUB carries both; its OpenLane tool is
    OpenLane 1, the Tcl flow that stopped with Efabless. LibreLane is the
    continuation of OpenLane 2 under the FOSSi Foundation and the nanoHUB build is
    its maintainers'. Same OpenROAD, Yosys, Magic, Netgen and KLayout underneath;
    what differs is a step graph that can be stopped and resumed, which the full
    core needs because it takes two passes.
    sky130A with sky130_fd_sc_hd. sky130 and ihp-sg13g2 are both 130 nm and nothing
    open goe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
2026-08-26 Find LibreLane when it is installed but not on PATH
    nanoHUB exports PDK_ROOT pointing into /apps/share64/rocky8/librelane/
    librelane-3.0.4/pdks, so the install is right there -- but the entry point is
    not on PATH and find_flow only ever looked at PATH, $LIBRELANE and
    $OPENLANE_ROOT. It gave up on a machine that has LibreLane 3.0.4 sitting on it.
    The PDK it already found is the best clue about where the rest of it is, so
    find_pdk now runs first and find_flow searches next to PDK_ROOT, plus the
    /apps/share64/*/librelane* layout, for bin/librelane or a venv holding it.
    When it still cannot find one it prints every path it tried and the two
    commands that would locate the entry point, rather th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
2026-08-26 Search the install tree for the entry point instead of guessing at it
    The roots were right -- PDK_ROOT led straight to
    /apps/share64/rocky8/librelane/librelane-3.0.4 -- but probing bin/librelane and
    venv/bin/librelane under them found nothing, and adding more guesses is not a
    strategy. It now runs find over each root, and falls back to looking for an
    importable librelane package to drive through `python -m` with PYTHONPATH set.
    The failure message prints the roots rather than sixty probed paths, and says
    how to see the tree and how to load a nanoHUB tool environment with `use`.
2026-08-26 Look where PATH is already pointing
    PATH on nanoHUB starts with /apps/librelane/r8/bin -- an install directory the
    search never considered, because it only knew the /apps/share64/*/librelane
    layout. Any directory already on PATH whose own path mentions librelane or
    openlane is now a root, which is a better rule than another hardcoded glob.
    `which librelane` finds nothing in that directory, so the entry point is not
    called plainly `librelane`. The search now matches librelane* and openlane*
    and filters out the obvious non-executables, rather than requiring an exact
    name.
    nanoHUB also runs tools through `submit` rather than invoking them directly,
    which the .submit file in ~/LIBRELANE is the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
2026-08-26 Ask the config generator which modules exist
    modules() still read the sv2v flat file to validate a target name, so under the
    slang frontend -- which never writes one -- every target came back as "no
    module 'prf'". It now asks gen_config.py, which answers for whichever frontend
    is in use.
    Also: the search settled on rhel8's librelane-dev-20251219 while PDK_ROOT
    points at rocky8's librelane-3.0.4, because the shallow site-packages guesses
    missed 3.0.4's layout and the loop moved on. It now looks properly under each
    root before trying the next, so the root nearest the PDK gets a fair chance,
    and warns when the flow and the PDK still end up from different installs --
    a dev build driving a relea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
2026-08-26 Run LibreLane with a Python that can import it
    The system python3 on nanoHUB is 3.6. librelane/__version__.py imports
    importlib.metadata, which arrived in 3.8, so `python3 -m librelane` dies during
    import no matter which install it points at:
    ModuleNotFoundError: No module named 'importlib.metadata'
    The interpreter that runs this script and the interpreter that runs the flow
    are two different questions. flow_python now looks for one that is at least
    3.8, preferring whatever ships beside the install, and reports which it chose
    and what version. If there is none it says so directly, with where to look for
    the one the install ships, rather than failing inside an import trace.
    Version selec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
2026-08-27 Write down how to get a shell that can run LibreLane here
    Working this out took longer than building the flow did, and none of it is
    guessable from the outside: the wrapper, the empty root it needs, that git does
    not work inside the devshell, and the four things that look like the entry
    point and are not.
2026-08-27 Digest a run instead of reading it
    A Classic flow run is ~80 steps and tens of megabytes of tool output, and
    watching it scroll tells you almost nothing. Every step writes state_out.json
    holding its metrics, so the useful view is the diff: what each step changed.
    ./rtl2gds.sh report <module> prints, from the run directory alone:
    - every step that moved a metric or took over 30 seconds, with what it moved
    - any ERROR/FATAL line from that step's logs, inline
    - the final numbers
    - the three slowest steps
    It reads a run directory and nothing else, so it works while a run is still
    going and needs no tools -- including from outside the devshell.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
2026-08-27 Write down what this cost, so the next repo does not pay it again
    asic/PLAYBOOK.md is meant to be copied into another project and handed to a
    fresh session before it starts building a flow. Almost none of it is guessable
    from outside a real nanoHUB session, and several items contradict what a
    reasonable person would assume:
    - LibreLane 3 runs inside bubblewrap; the entry point is a wrapper that needs
    an empty root directory nothing creates for you
    - the librelane directory at the front of PATH holds session launchers only
    - the system python3 is too old to import librelane at all
    - published sv2v binaries cannot link against this glibc
    - USE_SLANG reads SystemVerilog directly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
2026-08-27 Stop reporting success for runs that failed
    Every design in the overnight synth-only run failed in step 5 of 80 and the
    script printed "ok" for all of them. Two causes, both mine: harden() returned
    an unconditional 0 on the --synth-only path, and collect() treated the mere
    existence of metrics.json as proof, when a run that dies early writes one too.
    Success now has to show a cell count.
    Add build/errors.log while I am here. A failure's cause is one line in one step
    log inside one design's run directory, and with -j several designs interleave
    on the way past -- so every failure now appends its module, exit code, last
    step and deduplicated error lines to a single file, and the summary ends w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
    [frontend.sv, ooo_backend.sv, rename_rob.sv]
2026-08-27 Run the front end here instead of finding out there
    Slang is on PyPI as pyslang, so the elaboration LibreLane does in step 5 of 80
    can happen locally in about a second per design. Everything below was found in
    the twenty minutes after installing it; the previous three failures each cost a
    round trip to nanoHUB and back.
    scripts/slang_check.py builds its file list by calling gen_config's own
    function, so it is not a lookalike -- same files, same order, same include path,
    same absent SIMULATION define. ./rtl2gds.sh check runs it, and so does every
    hardening run before it starts. scripts/slang_lint.py is the fallback when
    pyslang is absent: a regex pass for the same two rules, needing nothing.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
    [branch_controller.sv, d_cache.sv, d_prefetcher.sv, perceptron_predictor.sv, statistical_corrector.sv]
2026-08-30 Reset a table with one assignment, never a loop
    nanoHUB's errors.log named three causes for four failed designs. Two blocks
    were killed by the OOM killer inside ABC (return code 137, plus one exit 1 with
    no diagnostic at all, which is what a killed process looks like) -- that is a
    -j problem, not an RTL one. The other two hit yosys-slang.
    pyslang is not yosys-slang, and I had claimed otherwise. LibreLane runs the
    Yosys frontend, which refuses two things plain slang accepts: a for loop past
    --unroll-limit (4000), and any nonblocking assignment to a variable already
    written blocking. statistical_corrector came back clean from ./rtl2gds.sh check
    and died at step 5 on both. The docs now say wha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
    [statistical_corrector.sv, tage_m1.sv, tage_predictor.sv]
2026-08-30 Measure the memory instead of guessing at -j
    The -j default was nproc capped at 4, and 4 is what put frontend and
    issue_queue in the OOM killer inside ABC on a real run. Capped at 2 now, but
    the cap is the smaller half of the fix: every run wraps each design in GNU time
    and reports the largest resident set it reached, then does the arithmetic
    against MemTotal and says what -j actually fits, and whether the run just
    exceeded it. Reserves a quarter of the node, because ABC's peak is brief and
    the OOM killer does not care. Falls silent where GNU time is not installed.
    Also clears three reset loops in the retired predictors that my own earlier fix
    had turned into landmines. Converting counters[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
    [branch_controller.sv, perceptron_predictor.sv, tournament_predictor.sv]
2026-08-30 Stop claiming a slang binary is waiting on the remote machine
    yosys-slang is a Yosys plugin LibreLane loads as read_slang, not a standalone
    CLI, so `command -v slang` finds nothing in the devshell and bare yosys reports
    "No such command". The fallback message and the playbook both said the install
    ships one. It does not. The binary backend stays -- it costs one subprocess
    call and some builds do ship a CLI -- but nothing should plan around it.
    The more useful correction is what to do instead: on the machine that runs the
    flow, --synth-only IS the yosys-slang test. 01-yosys-jsonheader is the step
    that runs it and it fails in seconds, so a separate pre-flight there buys
    almost nothing. The pr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
2026-08-30 Do not take memory advice from a run that died in its first step
    The peak reporting I added an hour ago printed "-j 4785 is what fits" on
    nanoHUB. Two causes, both mine.
    It averaged in designs that had failed. tage_m1 died at step 1 of 80 having
    allocated 0.06 GB, which measures nothing except how fast it failed, and
    dividing the node by that produces a four-digit recommendation. Failed designs
    are now excluded, and when every design failed it says so instead of doing
    arithmetic on nothing.
    It also divided MemTotal, and nanoHUB reports 377 GB of machine while capping
    the session far below that -- which is how ABC got OOM killed on a box with
    hundreds of gigabytes free. It now prefers whate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
2026-08-30 Write down that the session cap is 6 GB, not 377
    /proc/meminfo on nanoHUB reports 377 GB and /sys/fs/cgroup/memory.max says
    6442450944 -- six gigabytes, a factor of 63 smaller. Every OOM kill in this
    project happened on a machine with hundreds of gigabytes free, because the
    cgroup is what the killer enforces. The flow already prefers the cgroup limit
    as of the last commit; this records why, and what 6 GB implies: ABC peaks near
    a gigabyte on a 150,000-cell block, so -j 2 is about right and -j 4 is what
    killed three designs. It also makes hierarchical hardening a memory argument
    rather than only a tractability one, since each block is a separate process
    with its own ceiling.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
2026-08-30 Ask the parser instead of guessing with regexes
    The regex check for mixed blocking/nonblocking assignment has now been wrong
    five times: nested bracket indices, DPI prototypes that open a scope and never
    close it, non-ANSI port lists, an assignment split across two lines, and
    `if (cond) x <= y` where the statement begins with a keyword. Every one of them
    printed "0 findings" while yosys-slang failed the run on the very case it had
    just cleared.
    scripts/mixed_assign.py reads slang's parse tree instead -- AssignmentExpression
    against NonblockingAssignmentExpression inside an Always*Block, each lvalue
    resolved to its base identifier. Pointed at the known failure before being
    trusted, it report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
    [tage_m1.sv]
2026-08-30 Keep the cell count when the run gets killed
    statistical_corrector reached step 135 of synthesis and was killed entering
    ABC, having printed "Number of cells: 795744" thirty passes earlier. That
    number is what the whole calibration exercise is for, and it was being thrown
    away with the run. record_failure now rescues the largest cell count any step
    log printed and records it alongside the failure.
    Both designs died to the OOM killer, not to a language error: tage_m1 during
    elaboration at PROC_DLATCH, statistical_corrector entering technology mapping.
    Neither produced a diagnostic, which is what a killed process looks like and
    why the log tail added earlier is what made this readable at all.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
2026-08-31 Let a hierarchical run stop and be picked up later
    do_hier re-hardened every block from scratch on each invocation, so a chain
    that takes longer than one sitting could never be finished -- which is the
    normal case, since hardening a 795,744-cell block is hours and the chain is
    days. A block whose LEF is already in results/ is now adopted as a macro and
    skipped, and the top is skipped if its GDS is there. Delete results/<module> to
    force a rebuild.
    The skip applies under --dry-run too, so a dry run answers "what happens if I
    start it now" rather than "what would have happened from nothing", which is the
    more useful question and the one that made this testable.
    frontend joins the default cut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
2026-08-31 Cut the README to the measurements
    1569 lines to 573. Every measured table, mechanism description and negative
    result is intact; what went was the narrative around them.
    Removed: the running commentary about which earlier conclusion each section
    reversed, the "SETTLED / STILL TRUE" annotations, the three-wide and two-wide
    snapshots that had been superseded twice over, seven GitHub-hosted diagrams, and
    about thirty internal cross-references that stitched a chronology together
    rather than explaining anything. Several things were said twice -- the
    corrector's motivation, the LSQ non-result, the occupancy counters misleading --
    and are now said once.
    Restructured so the results come first rath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
2026-08-31 Put the diagrams back
    All six, same assets, rehomed to the sections that survived the cut: the
    baseline pipeline with the note about the in-order RTL still being in the tree,
    the perceptron and chooser beside the tournament component accuracies, the two
    renaming diagrams under Register renaming, and the stream buffer beside the
    instruction-side prefetch discussion.
    The tournament geometry and the stream buffer's pipelining had gone with the
    prose around them; both are back in a sentence each, since a diagram with no
    text next to it explains less than either alone. 573 -> 599 lines.
2026-08-31 Draw the architecture as a diagram GitHub can render
    Replaces the ASCII block with a mermaid flowchart, so the picture lives in the
    file as text rather than as another uploaded PNG and stays diffable when a size
    changes.
    It carries what the ASCII one could not: the predictor and BTB both feeding the
    next-pc decision, the stream buffer and data prefetcher filling their caches on
    their own AXI ids, five read masters into the arbiter, and the three edges out
    of commit that close loops back into the machine -- squash to the pc, stores to
    the D-cache, and training to the predictor.
    Not rendered locally: mermaid.ink is Cloudflare-blocked, kroki's mermaid backend
    500s, and there is no node here.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
2026-08-31 Flatten the front end in the diagram
    Six levels deep made that subgraph a tall column. Now four:
    - the "taken?" rhombus is gone; the BTB and the predictor each label their own
    edge back to the pc, which says the same thing without a rank of its own
    - decode, rename and dispatch are one box, since they are one in-order group
    four instructions wide and the diagram was not saying anything by splitting
    them
    - the stream buffer is a line inside the I-cache box rather than a node beside
    it, which is closer to how it behaves anyway -- it fills the cache and is
    never addressed by the rest of the machine
    Also `direction LR` on that subgraph so the chain runs across rather than down.
    Merma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
2026-08-31 Wire the diagram stage to stage, not component to component
    The height was coming from the edges, not the boxes. RN reached into the issue
    queue, IC into the arbiter, LSQ into the D-cache, CM back to the pc and to the
    predictor -- five edges crossing three subgraph boundaries, each one pulling its
    endpoints apart until the front end was a tall column.
    Now the pipeline is five stages, each its own section with its components
    inside, and every edge that leaves a section attaches to the *section*:
    FETCH ==> RENAME ==> EXEC ==> MEMORY ==> COMMIT
    with the squash-and-train feedback and the two arbiter paths as the only others.
    No node has an edge crossing a boundary any more.
    That should a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
